oilcrest/xESC/PCB/xESC2.kicad_pcb

## KiCad design PCB/xESC2.kicad_pcb (2025-07-16)

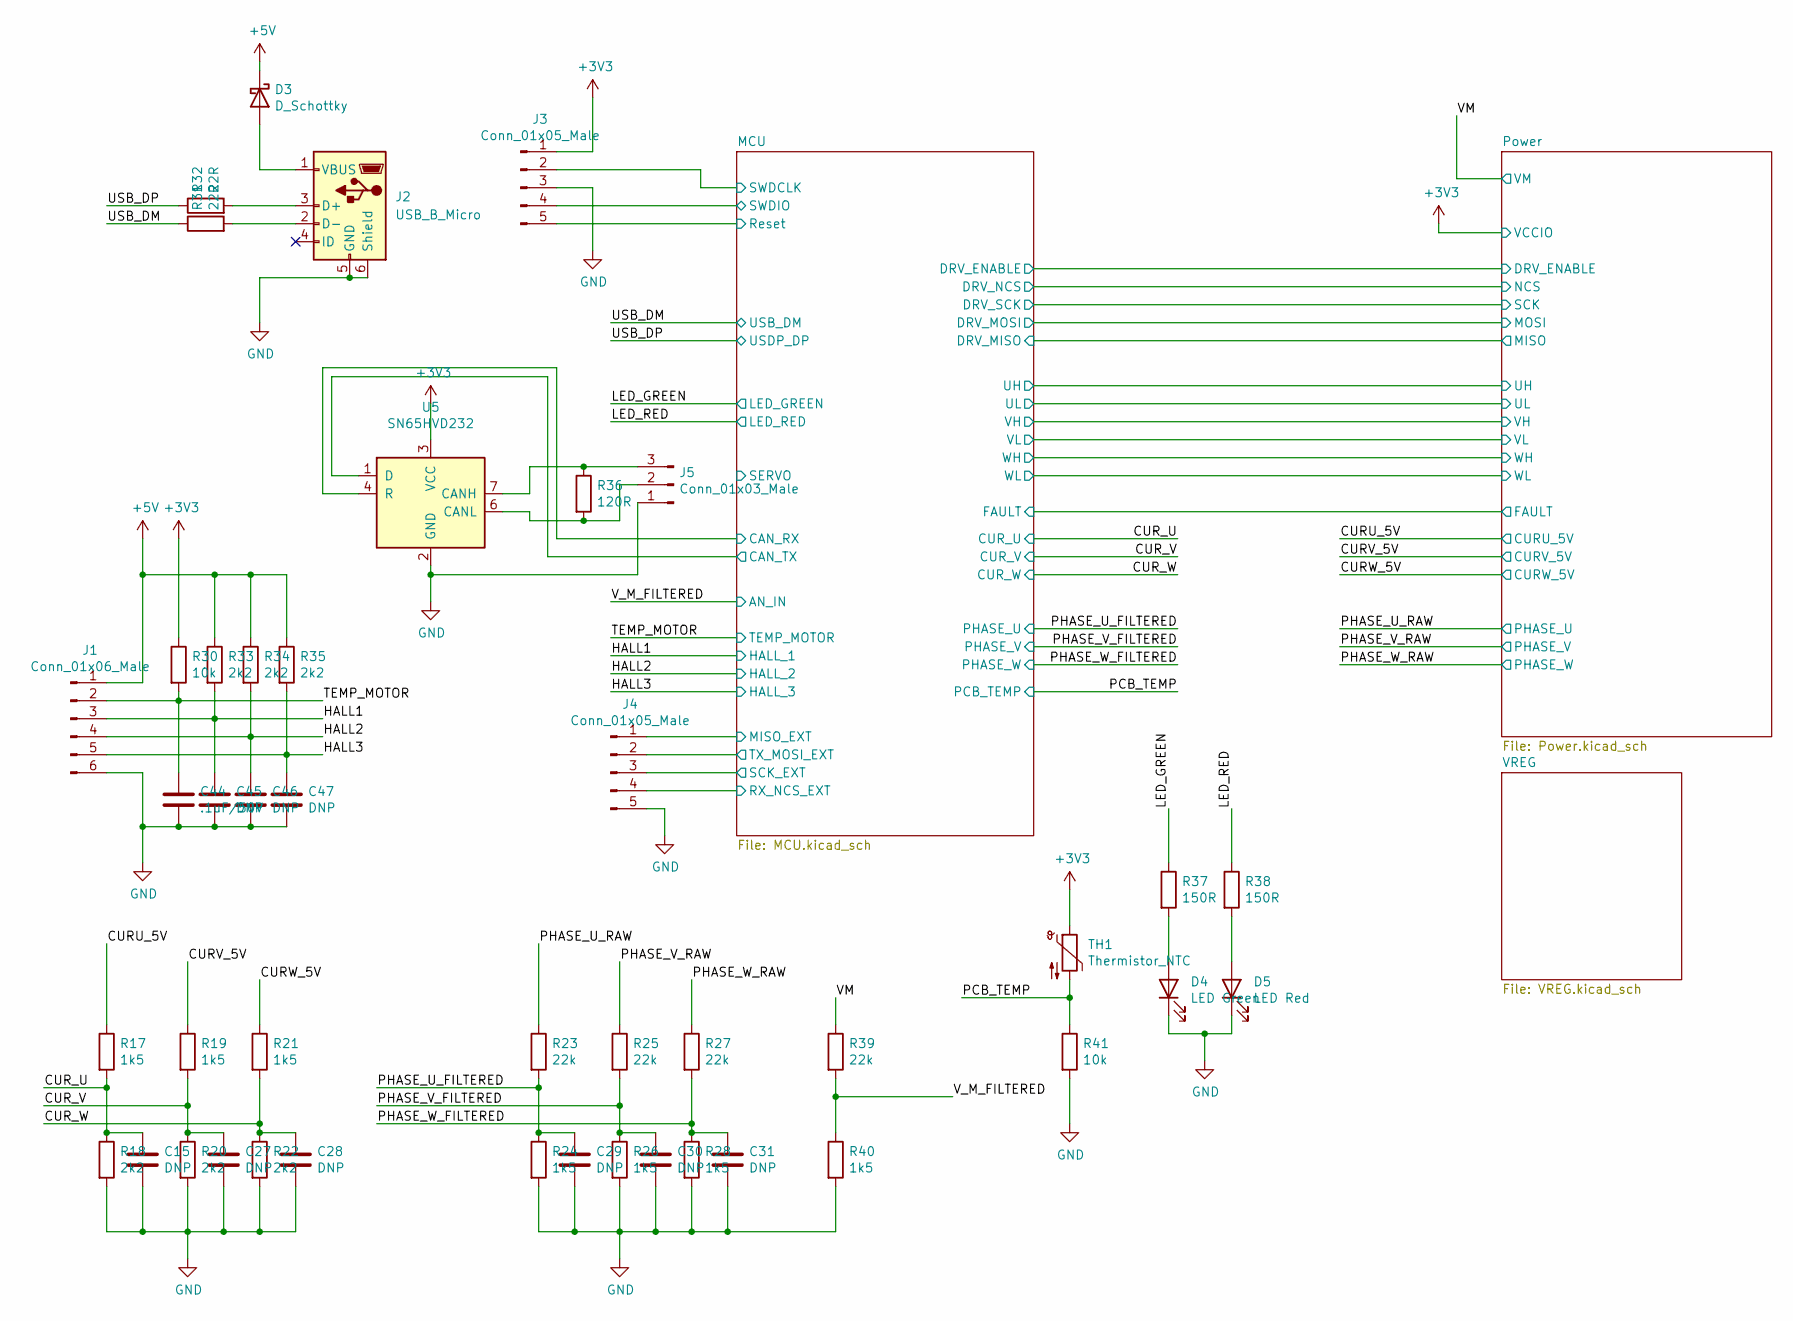
[picture p1: schematic xESC2.kicad_sch, xESC BLDC Controller]

Parts:
C15, C27, C28, C29, C30, C31, C45, C46, C47: DNP; C_0603_1608Metric
C44: .1uF/50V; C_0603_1608Metric; Part Number CL10B104KC8NNNC; Digikey 1276-1935-1-ND
D3: D_Schottky; D_SOD-123; Part Number PMEG2010ER,115; Digikey 1727-5192-1-ND
D4: LED Green; LED_0603_1608Metric; Part Number LTST-C191KGKT; Digikey 160-1446-1-ND
D5: LED Red; LED_0603_1608Metric; Part Number LTST-C191KRKT; Digikey 160-1447-1-ND
J1: Conn_01x06_Male; PinHeader_1x06_P2.54mm_Vertical; Part Number DZ254R-11-06-63; LCSC C2935912
J2: USB_B_Micro; USB_Micro; JLC C145795
J3, J4: Conn_01x05_Male; PinHeader_1x05_P2.54mm_Vertical; Part Number DZ254R-11-05-63; LCSC C2935911
J5: Conn_01x03_Male; PinHeader_1x03_P2.54mm_Vertical; Part Number DZ254R-11-05-63; LCSC C2935909
R17, R19, R21, R24, R26, R28, R40: 1k5; R_0603_1608Metric; Part Number RC0603FR-071K5L; Digikey 311-1.50KHRCT-ND
R18, R20, R22, R33, R34, R35: 2k2; R_0603_1608Metric; Part Number RC0603FR-072K2L; Digikey 311-2.20KHRCT-ND
R23, R25, R27, R39: 22k; R_0603_1608Metric; Part Number RMCF0603FT22K0; Digikey RMCF0603FT22K0CT-ND
R30, R41: 10k; R_0603_1608Metric; Part Number RC0603FR-0710KL; Digikey 311-10.0KHRCT-ND
R31, R32: 22R; R_0603_1608Metric; Part Number RMCF0603FT22R0; Digikey RMCF0603FT22R0CT-ND
R36: 120R; R_0603_1608Metric; Part Number RMCF0603FT120R; Digikey RMCF0603FT120RCT-ND
R37, R38: 150R; R_0603_1608Metric; Part Number RC0603FR-07150RL; Digikey 311-150HRCT-ND
TH1: Thermistor_NTC; R_0603_1608Metric; Part Number NCU18XH103F60RB; Digikey 490-16279-1-ND
U5: SN65HVD232; SOIC-8_3.9x4.9mm_P1.27mm; Part Number SN65HVD232; Digikey 296-12282-5-ND

Connections:
+3V3: J3.1, R30.1, TH1.1, U5.3 (VCC); also elsewhere on the board
+5V: D3.1 (K), J1.1, R33.1, R34.1, R35.1; also elsewhere on the board
/CURU_5V: R17.1; also elsewhere on the board
/CURV_5V: R19.1; also elsewhere on the board
/CURW_5V: R21.1; also elsewhere on the board
/CUR_U: C15.1, R17.2, R18.1; also elsewhere on the board
/CUR_V: C27.1, R19.2, R20.1; also elsewhere on the board
/CUR_W: C28.1, R21.2, R22.1; also elsewhere on the board
/HALL1: C45.1, J1.3, R33.2; also elsewhere on the board
/HALL2: C46.1, J1.4, R34.2; also elsewhere on the board
/HALL3: C47.1, J1.5, R35.2; also elsewhere on the board
/LED_GREEN: R37.1; also elsewhere on the board
/LED_RED: R38.1; also elsewhere on the board
/MCU/CAN_RX: U5.4 (R); also elsewhere on the board
/MCU/CAN_TX: U5.1 (D); also elsewhere on the board
/MCU/MISO_EXT: J4.1; also elsewhere on the board
/MCU/RX_NCS_EXT: J4.4; also elsewhere on the board
/MCU/Reset: J3.5; also elsewhere on the board
/MCU/SCK_EXT: J4.3; also elsewhere on the board
/MCU/SWDCLK: J3.2; also elsewhere on the board
/MCU/SWDIO: J3.4; also elsewhere on the board
/MCU/TX_MOSI_EXT: J4.2; also elsewhere on the board
/PCB_TEMP: R41.1, TH1.2; also elsewhere on the board
/PHASE_U_FILTERED: C29.1, R23.2, R24.1; also elsewhere on the board
/PHASE_U_RAW: R23.1; also elsewhere on the board
/PHASE_V_FILTERED: C30.1, R25.2, R26.1; also elsewhere on the board
/PHASE_V_RAW: R25.1; also elsewhere on the board
/PHASE_W_FILTERED: C31.1, R27.2, R28.1; also elsewhere on the board
/PHASE_W_RAW: R27.1; also elsewhere on the board
/TEMP_MOTOR: C44.1, J1.2, R30.2; also elsewhere on the board
/USB_DM: R31.1; also elsewhere on the board
/USB_DP: R32.1; also elsewhere on the board
/VM: R39.1; also elsewhere on the board
/V_M_FILTERED: R39.2, R40.1; also elsewhere on the board
GND: C15.2, C27.2, C28.2, C29.2, C30.2, C31.2, C44.2, C45.2, C46.2, C47.2, D4.1 (K), D5.1 (K), J1.6, J2.5 (GND), J2.6 (Shield), J3.3, J4.5, J5.1, R18.2, R20.2, R22.2, R24.2, R26.2, R28.2, R40.2, R41.2, U5.2 (GND); also elsewhere on the board
unnamed: D3.2 (A), J2.1 (VBUS)
unnamed: D4.2 (A), R37.2
unnamed: D5.2 (A), R38.2
unnamed: J2.3 (D+), R32.2
unnamed: J2.2 (D-), R31.2
unnamed: J5.2, R36.2, U5.6 (CANL)
unnamed: J5.3, R36.1, U5.7 (CANH)

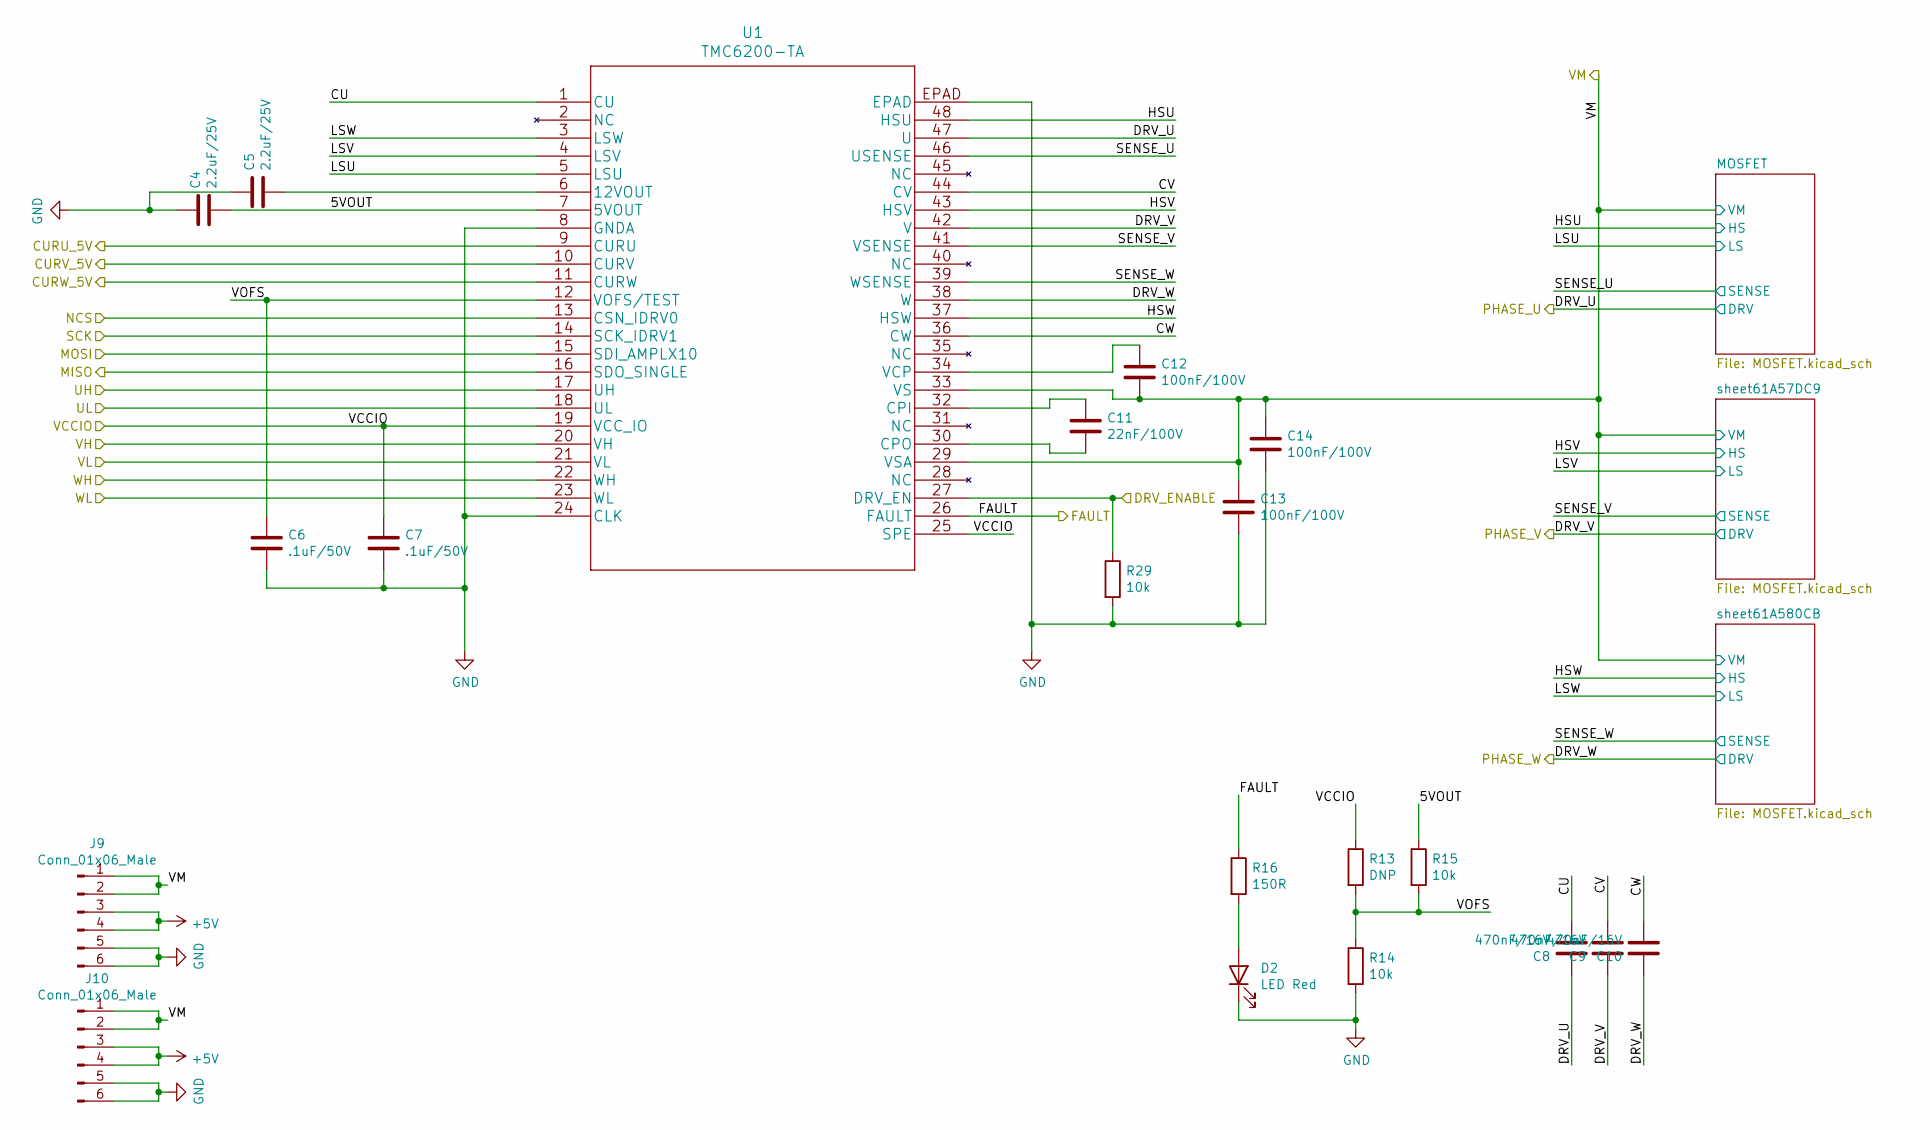
[picture p2: schematic Power.kicad_sch, xESC BLDC Controller]

Parts:
C4, C5: 2.2uF/25V; C_0805_2012Metric; Part Number GRM21BR71E225KE11L; Digikey 490-14467-1-ND
C6, C7: .1uF/50V; C_0603_1608Metric; Part Number CL10B104KC8NNNC; Digikey 1276-1935-1-ND
C8, C9, C10: 470nF/16V; C_0603_1608Metric; Part Number CL10B474KO8NNNC; Digikey 1276-1062-1-ND
C11: 22nF/100V; C_0603_1608Metric; Part Number C0603C223K1RAC7867; Digikey 399-C0603C223K1RAC7867CT-ND
C12, C13, C14: 100nF/100V; C_0805_2012Metric; Part Number HMK212BJ104KG-T; JLC C28233
D2: LED Red; LED_0603_1608Metric; Part Number LTST-C191KRKT; Digikey 160-1447-1-ND
J9, J10: Conn_01x06_Male; PinHeader_1x06_P2.54mm_Vertical; Part Number DZ254R-11-06-63; LCSC C2935912
R13: DNP; R_0603_1608Metric
R14, R15, R29: 10k; R_0603_1608Metric; Part Number RC0603FR-0710KL; Digikey 311-10.0KHRCT-ND
R16: 150R; R_0603_1608Metric; Part Number RC0603FR-07150RL; Digikey 311-150HRCT-ND
U1: TMC6200-TA; Part Number TMC6200-TA; Digikey 1460-1384-ND

Connections:
+3V3: C7.1, R13.1, U1.19 (VCC_IO), U1.25 (SPE); also elsewhere on the board
+5V: J9.3, J9.4, J10.3, J10.4; also elsewhere on the board
/CURU_5V: U1.9 (CURU); also elsewhere on the board
/CURV_5V: U1.10 (CURV); also elsewhere on the board
/CURW_5V: U1.11 (CURW); also elsewhere on the board
/MCU/DRV_ENABLE: R29.1, U1.27 (DRV_EN); also elsewhere on the board
/MCU/DRV_MISO: U1.16 (SDO_SINGLE); also elsewhere on the board
/MCU/DRV_MOSI: U1.15 (SDI_AMPLX10); also elsewhere on the board
/MCU/DRV_NCS: U1.13 (CSN_IDRV0); also elsewhere on the board
/MCU/DRV_SCK: U1.14 (SCK_IDRV1); also elsewhere on the board
/MCU/UH: U1.17 (UH); also elsewhere on the board
/MCU/UL: U1.18 (UL); also elsewhere on the board
/MCU/VH: U1.20 (VH); also elsewhere on the board
/MCU/VL: U1.21 (VL); also elsewhere on the board
/MCU/WH: U1.22 (WH); also elsewhere on the board
/MCU/WL: U1.23 (WL); also elsewhere on the board
/PHASE_U_RAW: C8.1, U1.47 (U); also elsewhere on the board
/PHASE_V_RAW: C9.1, U1.42 (V); also elsewhere on the board
/PHASE_W_RAW: C10.1, U1.38 (W); also elsewhere on the board
/Power/5VOUT: C4.2, R15.1, U1.7 (5VOUT)
/Power/CU: C8.2, U1.1 (CU)
/Power/CV: C9.2, U1.44 (CV)
/Power/CW: C10.2, U1.36 (CW)
/Power/FAULT: R16.1, U1.26 (FAULT); also elsewhere on the board
/Power/HSU: U1.48 (HSU); also elsewhere on the board
/Power/HSV: U1.43 (HSV); also elsewhere on the board
/Power/HSW: U1.37 (HSW); also elsewhere on the board
/Power/LSU: U1.5 (LSU); also elsewhere on the board
/Power/LSV: U1.4 (LSV); also elsewhere on the board
/Power/LSW: U1.3 (LSW); also elsewhere on the board
/Power/SENSE_U: U1.46 (USENSE); also elsewhere on the board
/Power/SENSE_V: U1.41 (VSENSE); also elsewhere on the board
/Power/SENSE_W: U1.39 (WSENSE); also elsewhere on the board
/Power/VOFS: C6.1, R13.2, R14.1, R15.2, U1.12 (VOFS/TEST)
/VM: C12.2, C13.1, C14.1, J9.1, J9.2, J10.1, J10.2, U1.29 (VSA), U1.33 (VS); also elsewhere on the board
GND: C4.1, C5.1, C6.2, C7.2, C13.2, C14.2, D2.1 (K), J9.5, J9.6, J10.5, J10.6, R14.2, R29.2, U1.8 (GNDA), U1.24 (CLK), U1.EPAD; also elsewhere on the board
unnamed: D2.2 (A), R16.2
unnamed: C5.2, U1.6 (12VOUT)
unnamed: C11.2, U1.32 (CPI)
unnamed: C11.1, U1.30 (CPO)
unnamed: C12.1, U1.34 (VCP)

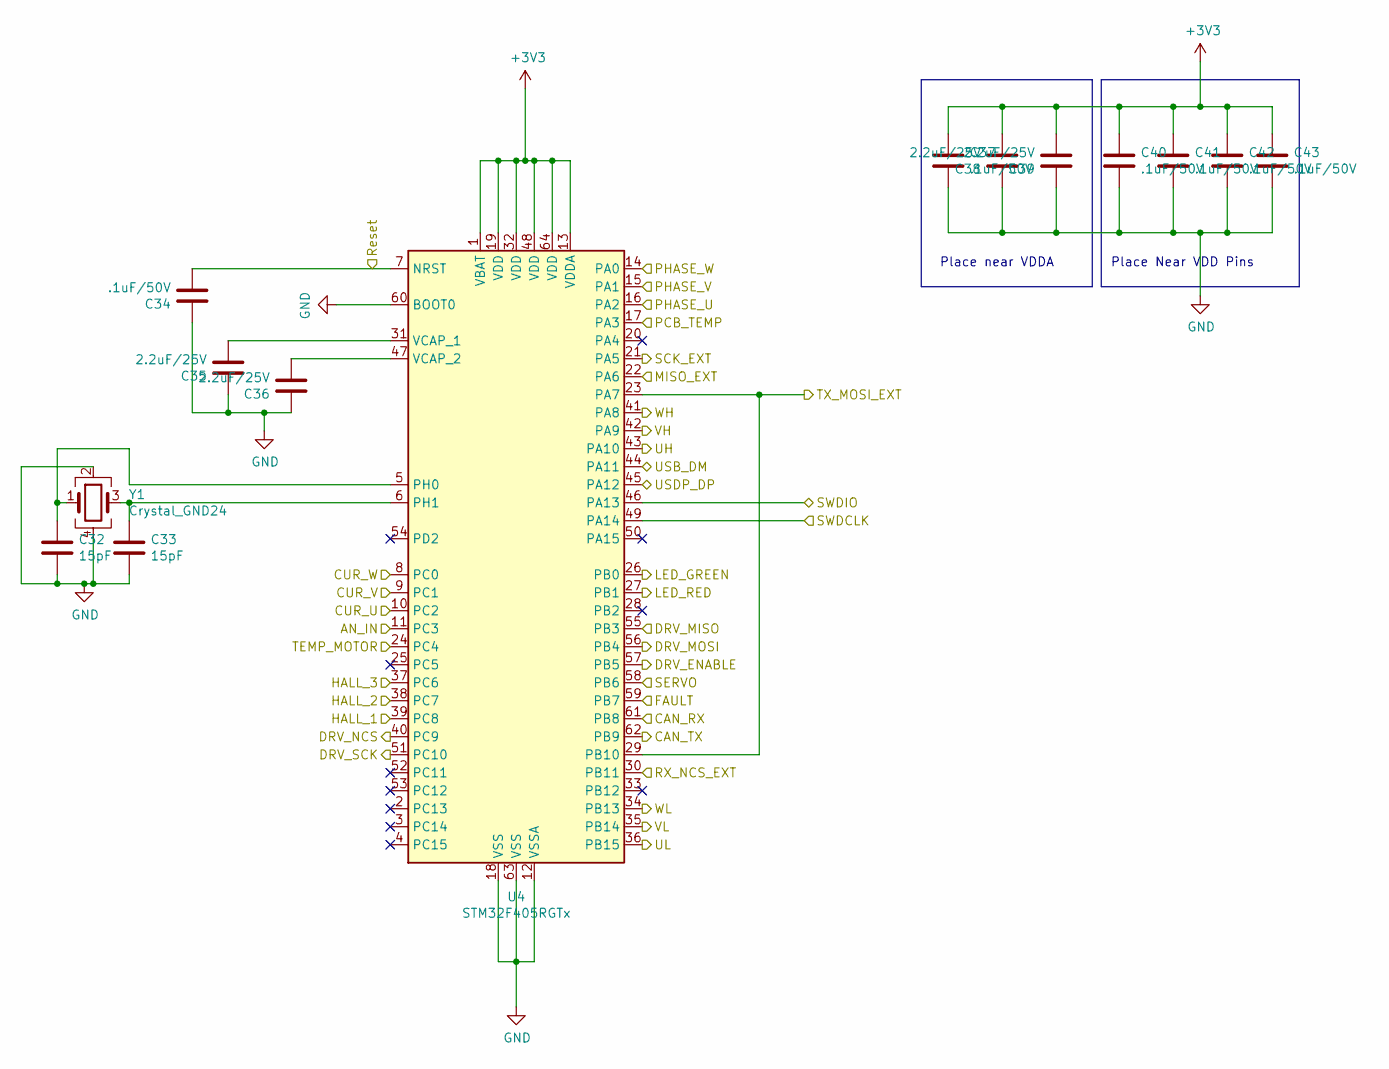
[picture p3: schematic MCU.kicad_sch, xESC BLDC Controller]

Parts:
C32, C33: 15pF; C_0603_1608Metric; Part Number GRM1885C2A150JA01D; Digikey 490-1331-1-ND
C34, C37, C40, C41, C42, C43: .1uF/50V; C_0603_1608Metric; Part Number CL10B104KC8NNNC; Digikey 1276-1935-1-ND
C35, C36, C38, C39: 2.2uF/25V; C_0805_2012Metric; Part Number GRM21BR71E225KE11L; Digikey 490-14467-1-ND
U4: STM32F405RGTx; LQFP-64_10x10mm_P0.5mm; Part Number STM32F405RGTx; LCSC C15742
Y1: Crystal_GND24; Crystal_SMD_3225-4Pin_3.2x2.5mm; Part Number ECS-80-12-33-JGN-TR; Digikey 50-ECS-80-12-33-JGN-CT-ND

Connections:
+3V3: C37.1, C38.2, C39.2, C40.1, C41.1, C42.1, C43.1, U4.1 (VBAT), U4.13 (VDDA), U4.19 (VDD), U4.32 (VDD), U4.48 (VDD), U4.64 (VDD); also elsewhere on the board
/CUR_U: U4.10 (PC2); also elsewhere on the board
/CUR_V: U4.9 (PC1); also elsewhere on the board
/CUR_W: U4.8 (PC0); also elsewhere on the board
/HALL1: U4.39 (PC8); also elsewhere on the board
/HALL2: U4.38 (PC7); also elsewhere on the board
/HALL3: U4.37 (PC6); also elsewhere on the board
/LED_GREEN: U4.26 (PB0); also elsewhere on the board
/LED_RED: U4.27 (PB1); also elsewhere on the board
/MCU/CAN_RX: U4.61 (PB8); also elsewhere on the board
/MCU/CAN_TX: U4.62 (PB9); also elsewhere on the board
/MCU/DRV_ENABLE: U4.57 (PB5); also elsewhere on the board
/MCU/DRV_MISO: U4.55 (PB3); also elsewhere on the board
/MCU/DRV_MOSI: U4.56 (PB4); also elsewhere on the board
/MCU/DRV_NCS: U4.40 (PC9); also elsewhere on the board
/MCU/DRV_SCK: U4.51 (PC10); also elsewhere on the board
/MCU/MISO_EXT: U4.22 (PA6); also elsewhere on the board
/MCU/RX_NCS_EXT: U4.30 (PB11); also elsewhere on the board
/MCU/Reset: C34.2, U4.7 (NRST); also elsewhere on the board
/MCU/SCK_EXT: U4.21 (PA5); also elsewhere on the board
/MCU/SERVO: U4.58 (PB6)
/MCU/SWDCLK: U4.49 (PA14); also elsewhere on the board
/MCU/SWDIO: U4.46 (PA13); also elsewhere on the board
/MCU/TX_MOSI_EXT: U4.23 (PA7), U4.29 (PB10); also elsewhere on the board
/MCU/UH: U4.43 (PA10); also elsewhere on the board
/MCU/UL: U4.36 (PB15); also elsewhere on the board
/MCU/VH: U4.42 (PA9); also elsewhere on the board
/MCU/VL: U4.35 (PB14); also elsewhere on the board
/MCU/WH: U4.41 (PA8); also elsewhere on the board
/MCU/WL: U4.34 (PB13); also elsewhere on the board
/PCB_TEMP: U4.17 (PA3); also elsewhere on the board
/PHASE_U_FILTERED: U4.16 (PA2); also elsewhere on the board
/PHASE_V_FILTERED: U4.15 (PA1); also elsewhere on the board
/PHASE_W_FILTERED: U4.14 (PA0); also elsewhere on the board
/Power/FAULT: U4.59 (PB7); also elsewhere on the board
/TEMP_MOTOR: U4.24 (PC4); also elsewhere on the board
/USB_DM: U4.44 (PA11); also elsewhere on the board
/USB_DP: U4.45 (PA12); also elsewhere on the board
/V_M_FILTERED: U4.11 (PC3); also elsewhere on the board
GND: C32.2, C33.2, C34.1, C35.1, C36.1, C37.2, C38.1, C39.1, C40.2, C41.2, C42.2, C43.2, U4.12 (VSSA), U4.18 (VSS), U4.60 (BOOT0), U4.63 (VSS), Y1.2, Y1.4; also elsewhere on the board
unnamed: C32.1, U4.5 (PH0), Y1.1
unnamed: C33.1, U4.6 (PH1), Y1.3
unnamed: C35.2, U4.31 (VCAP_1)
unnamed: C36.2, U4.47 (VCAP_2)

Notes on the sheet:
Place Near VDD Pins
Place near VDDA

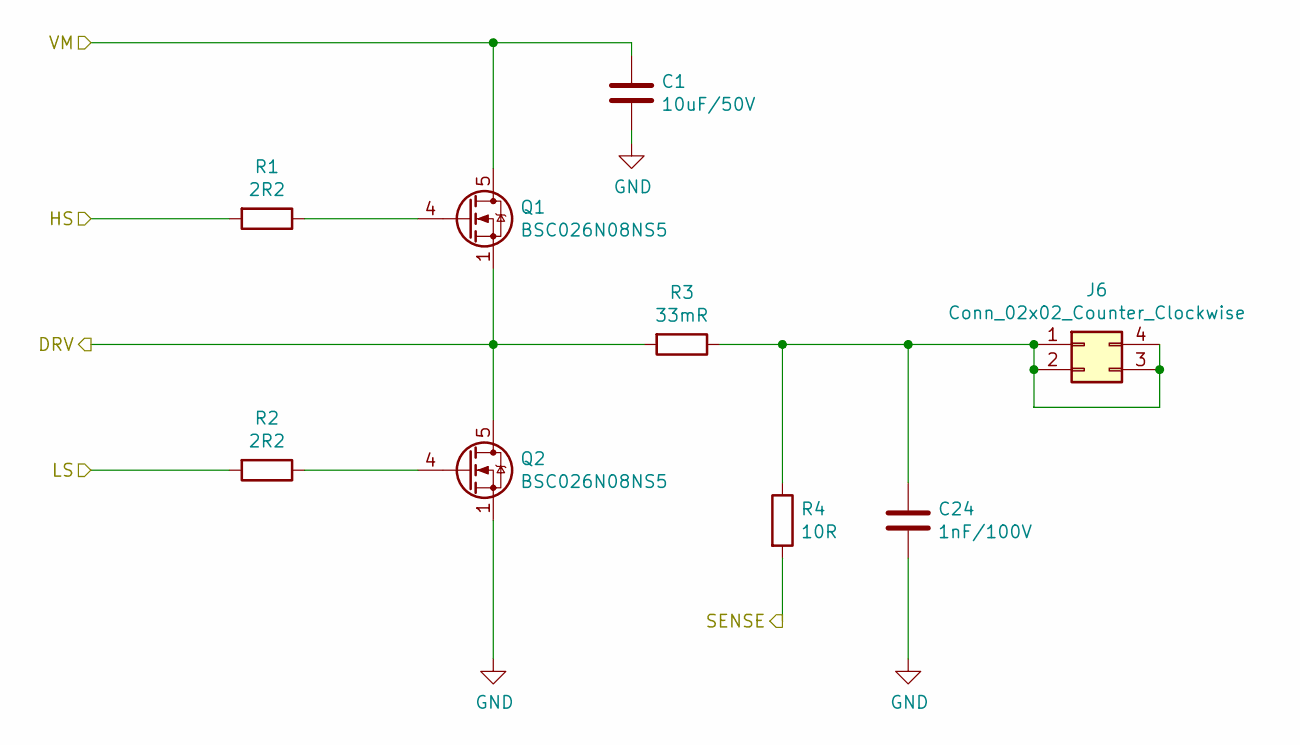
[picture p4: schematic MOSFET.kicad_sch, xESC BLDC Controller]

Parts:
C1: 10uF/50V; C_1206_3216Metric; Part Number CL31B225KBHVPNE; Digikey 1276-6735-1-ND
C24: 1nF/100V; C_0603_1608Metric; Part Number GCM188R72A102KA37D; Digikey 490-4780-1-ND
J6: Conn_02x02_Counter_Clockwise; PinHeader_2x02_P2.54mm_Vertical; Part Number B-2100S04P-B110; LCSC C124362
Q1, Q2: BSC026N08NS5; TDSON-8-1; Part Number BSC026N08NS5; Digikey BSC026N08NS5ATMA1CT-ND
R1, R2: 2R2; R_0603_1608Metric; Part Number ERJ-3GEYJ2R2V; Digikey P2.2GCT-ND
R3: 33mR; R_2512_6332Metric; Part Number ARP2512GJR033; LCSC C2903495
R4: 10R; R_0603_1608Metric; Part Number RMCF0603FT10R0; Digikey RMCF0603FT10R0CT-ND

Connections:
/PHASE_U_RAW: Q1.1 (S), Q1.2 (S), Q1.3 (S), Q2.5 (D), R3.2; also elsewhere on the board
/Power/HSU: R1.2; also elsewhere on the board
/Power/LSU: R2.2; also elsewhere on the board
/Power/SENSE_U: R4.2; also elsewhere on the board
/VM: C1.1, Q1.5 (D); also elsewhere on the board
GND: C1.2, C24.2, Q2.1 (S), Q2.2 (S), Q2.3 (S); also elsewhere on the board
unnamed: C24.1, J6.1, J6.2, J6.3, J6.4, R3.1, R4.1
unnamed: Q1.4 (G), R1.1
unnamed: Q2.4 (G), R2.1

Parts of its further copies:
C2, C3: 10uF/50V; C_1206_3216Metric; Part Number CL31B225KBHVPNE; Digikey 1276-6735-1-ND
C25, C26: 1nF/100V; C_0603_1608Metric; Part Number GCM188R72A102KA37D; Digikey 490-4780-1-ND
J7, J8: Conn_02x02_Counter_Clockwise; PinHeader_2x02_P2.54mm_Vertical; Part Number B-2100S04P-B110; LCSC C124362
Q3, Q4, Q5, Q6: BSC026N08NS5; TDSON-8-1; Part Number BSC026N08NS5; Digikey BSC026N08NS5ATMA1CT-ND
R5, R6, R9, R10: 2R2; R_0603_1608Metric; Part Number ERJ-3GEYJ2R2V; Digikey P2.2GCT-ND
R7, R11: 33mR; R_2512_6332Metric; Part Number ARP2512GJR033; LCSC C2903495
R8, R12: 10R; R_0603_1608Metric; Part Number RMCF0603FT10R0; Digikey RMCF0603FT10R0CT-ND

Connections of its further copies:
/PHASE_V_RAW: Q3.1 (S), Q3.2 (S), Q3.3 (S), Q4.5 (D), R7.2; also elsewhere on the board
/PHASE_W_RAW: Q5.1 (S), Q5.2 (S), Q5.3 (S), Q6.5 (D), R11.2; also elsewhere on the board
/Power/HSV: R5.2; also elsewhere on the board
/Power/HSW: R9.2; also elsewhere on the board
/Power/LSV: R6.2; also elsewhere on the board
/Power/LSW: R10.2; also elsewhere on the board
/Power/SENSE_V: R8.2; also elsewhere on the board
/Power/SENSE_W: R12.2; also elsewhere on the board
/VM: C2.1, C3.1, Q3.5 (D), Q5.5 (D); also elsewhere on the board
GND: C2.2, C3.2, C25.2, C26.2, Q4.1 (S), Q4.2 (S), Q4.3 (S), Q6.1 (S), Q6.2 (S), Q6.3 (S); also elsewhere on the board
unnamed: C25.1, J7.1, J7.2, J7.3, J7.4, R7.1, R8.1
unnamed: C26.1, J8.1, J8.2, J8.3, J8.4, R11.1, R12.1
unnamed: Q3.4 (G), R5.1
unnamed: Q4.4 (G), R6.1
unnamed: Q5.4 (G), R9.1
unnamed: Q6.4 (G), R10.1

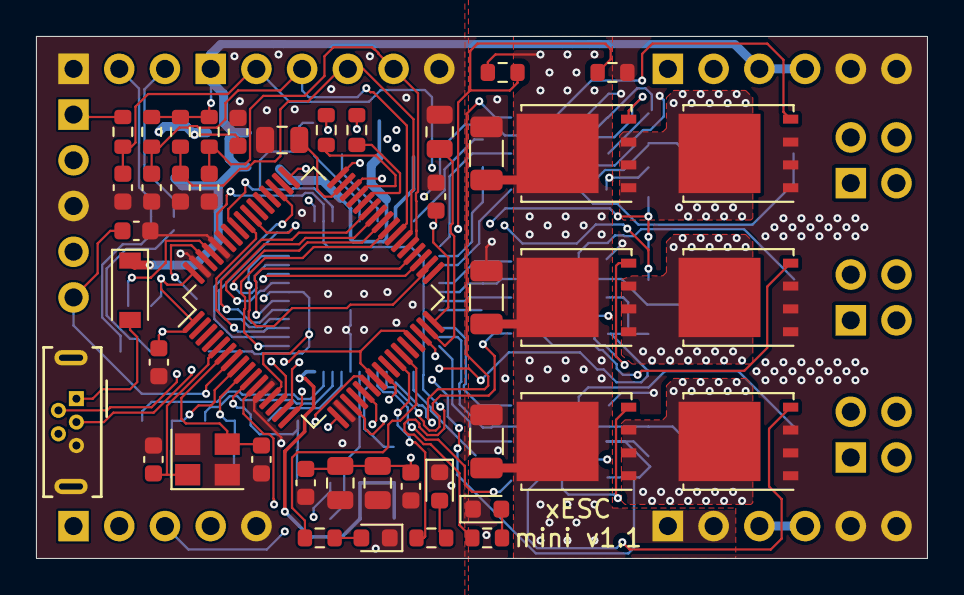
[picture p5: board xESC2.kicad_pcb from above]

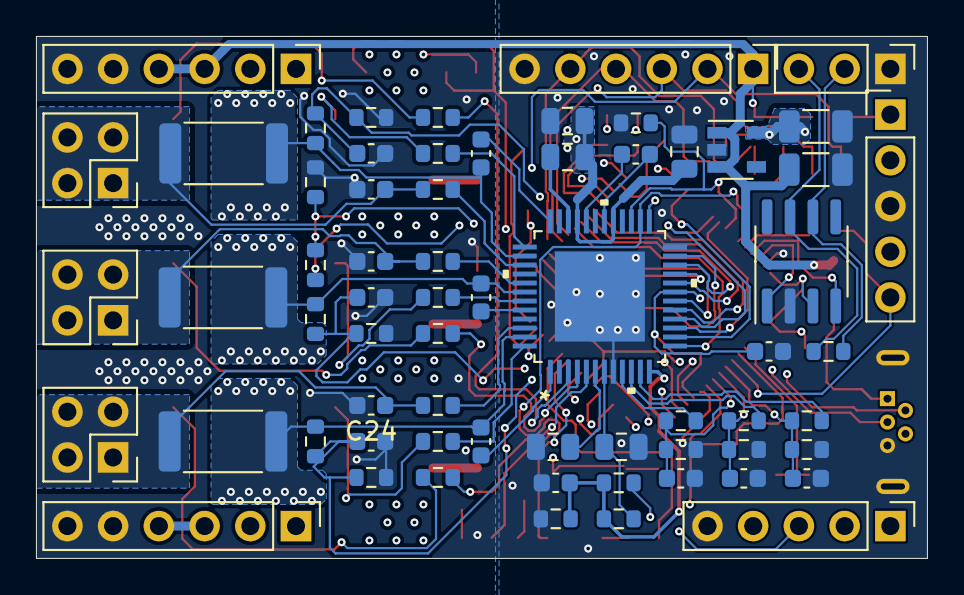
[picture p6: board xESC2.kicad_pcb from below]

Board: 4 copper layers, 49.5 x 29.0 mm, 108 parts (65 on the bottom side), 86 nets.

Other parts of the board:
C20, C21: 10uF/50V; C_1206_3216Metric
U2: XC6220B331MR; SOT-23-5

Their connections:
+3V3: C21.1, U2.5 (VOUT); also elsewhere on the board
+5V: C20.1, U2.1 (VIN), U2.3 (CE); also elsewhere on the board
GND: C20.2, C21.2, U2.2 (GND); also elsewhere on the board
