oilcrest/xESC/(commit log)

2025-07-16 Updated USB plug, Updated Part Numbers
    [MCU.kicad_sch, MOSFET.kicad_sch, Power.kicad_sch, xESC2.kicad_sch]
2025-07-16 Updated Y1 Part Number
    [MCU.kicad_sch, xESC2.kicad_pcb]
