oilcrest/xESC/(notices)

Notices in the files:
PCB/MCU.kicad_sch:
Creative Commons Attribution-NonCommercial-ShareAlike 4.0 International License.
Licensed under
parts and their libraries:
Copyright 2021 Accelerated Designs. All rights reserved.
